belovictor/Tripod/stl/Middle-bracket.stl

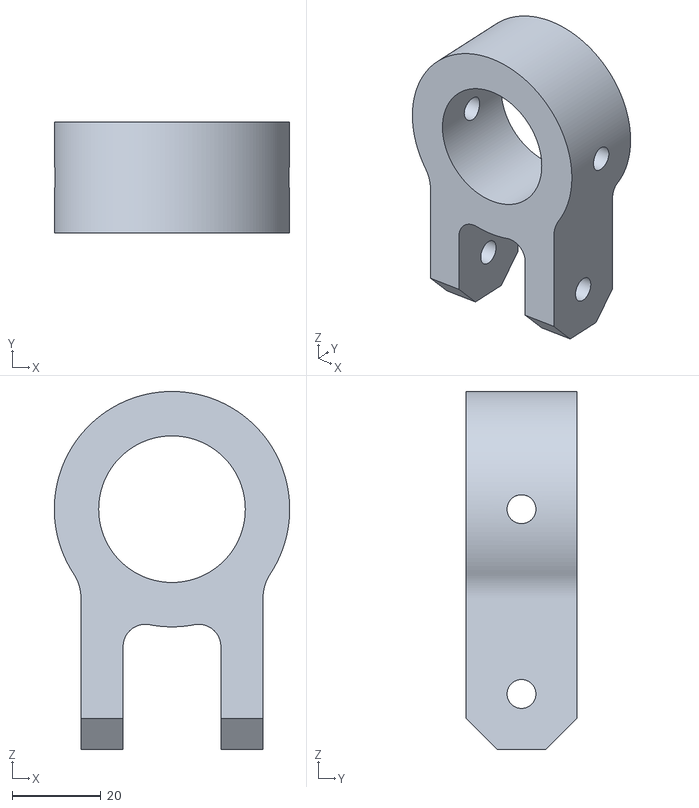
[picture p4: CAD file, 2023-02-11]
stl/Middle-bracket.stl
53.0 x 25.0 x 80.6
