belovictor/Tripod/stl/Foot.stl

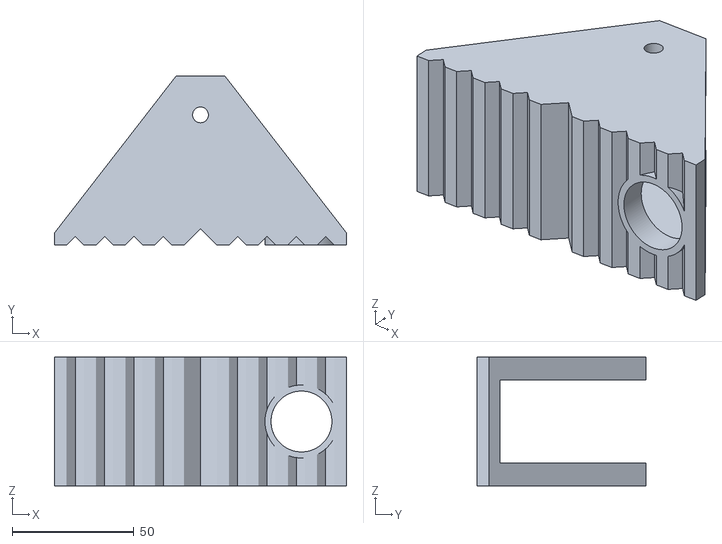
[picture p5: CAD file, 2023-02-11]
stl/Foot.stl
120.0 x 69.5 x 53.0
