belovictor/Tripod/stl/Bottom-cross.stl

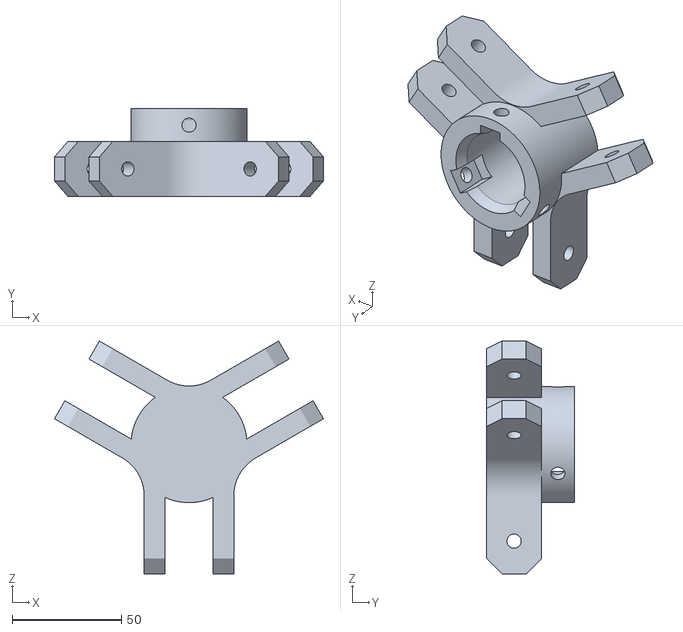
[picture p6: CAD file, 2023-02-11]
stl/Bottom-cross.stl
122.9 x 40.0 x 106.4
