belovictor/Tripod/stl/Top-cross.stl

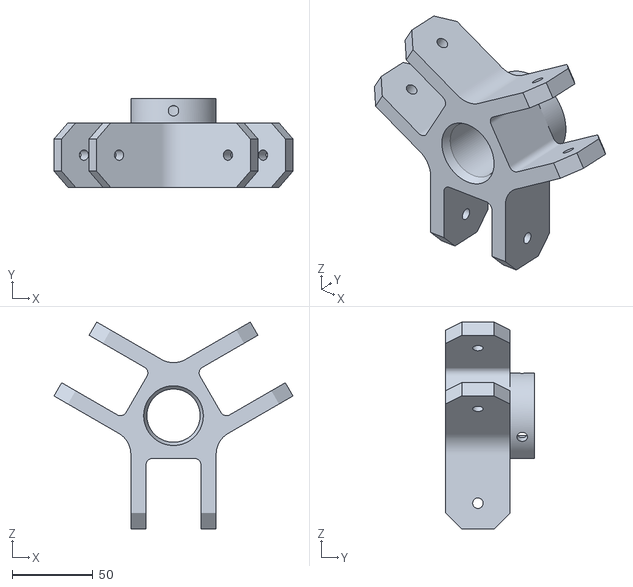
[picture p7: CAD file, 2023-02-11]
stl/Top-cross.stl
148.3 x 55.0 x 128.4
