belovictor/Tripod/pipes/Bottom-tube-20x220mm.pdf

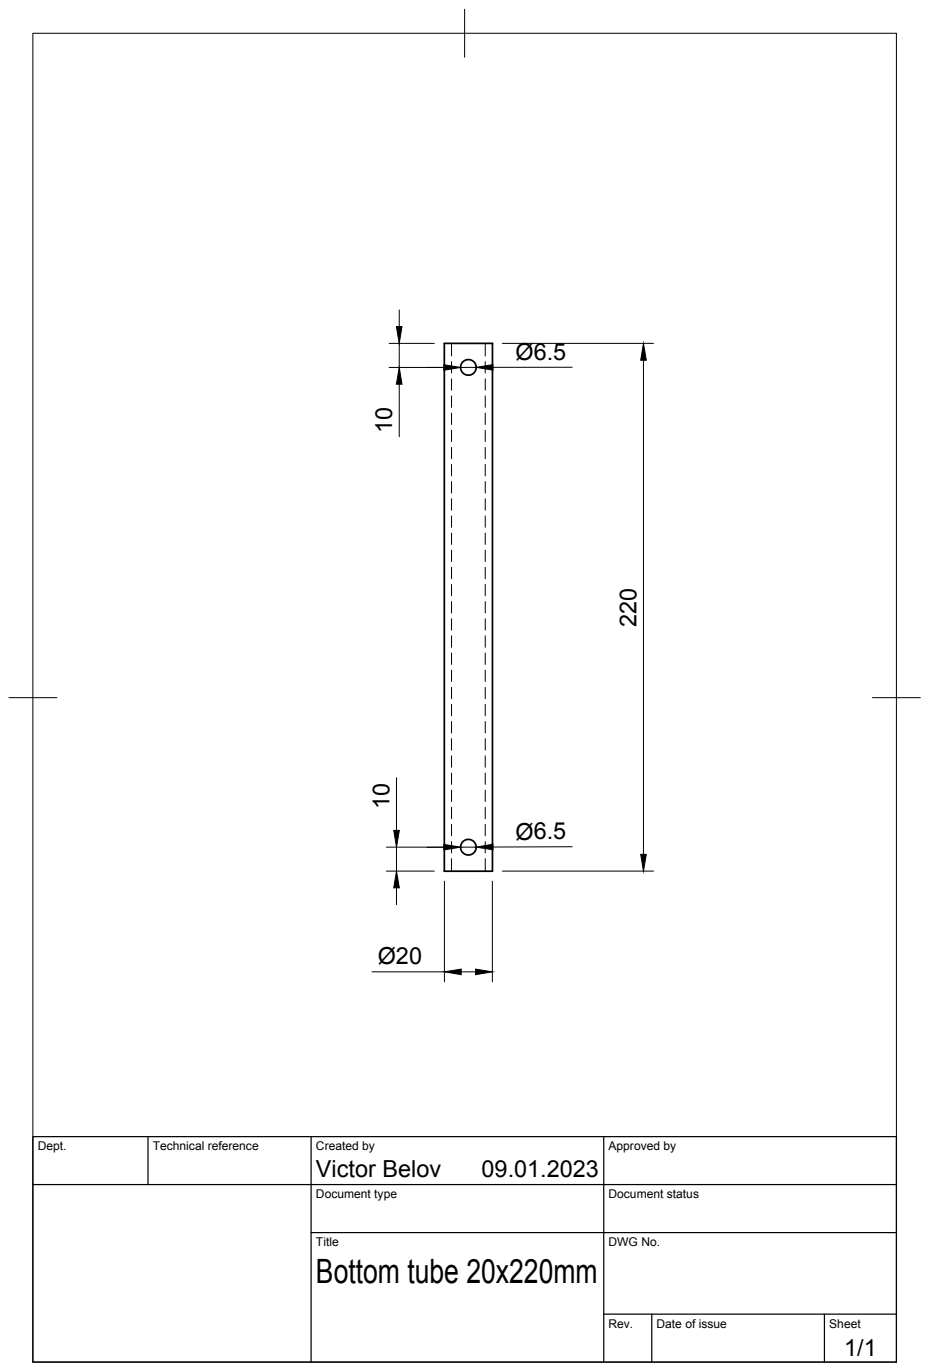
[picture p8: page 1]

Dept. | Technical reference | Created by Victor Belov 09.01.2023 | Approved by

Document type | Document status

Title Bottom tube 20x220mm | DWG No.

Rev. | Date of issue | Sheet 1/1
