belovictor/Tripod/pipes/Foot-tube-32x900mm.pdf

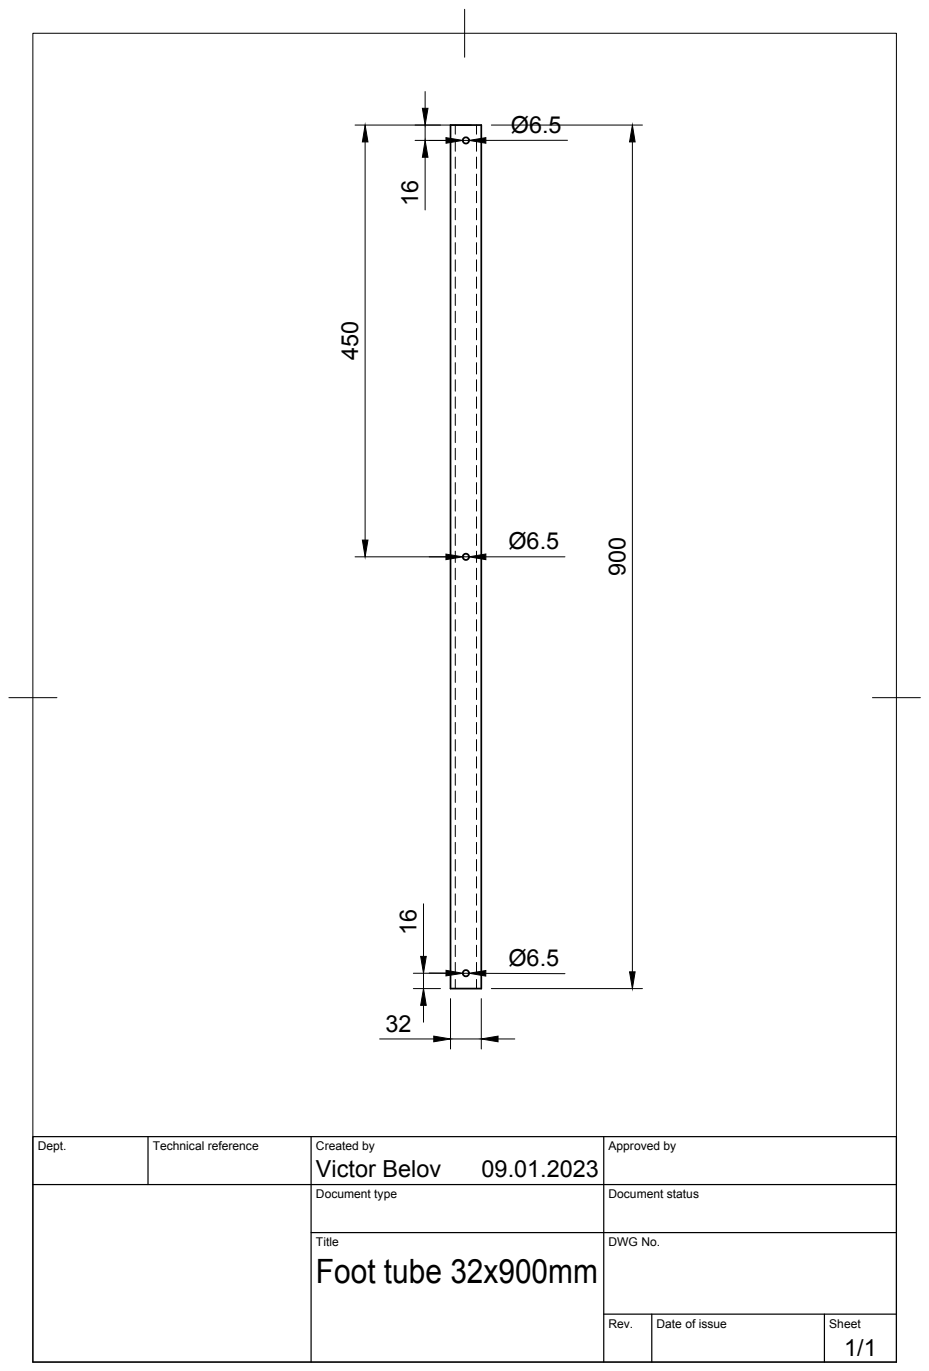
[picture p9: page 1]
Victor Belov

Dept. | Technical reference | Created by 09.01.2023 | Approved by

Document type | Document status

Title Foot tube 32x900mm | DWG No.

Rev. | Date of issue | Sheet 1/1
