belovictor/Tripod/pipes/Vertical-tube-32x1000mm.pdf

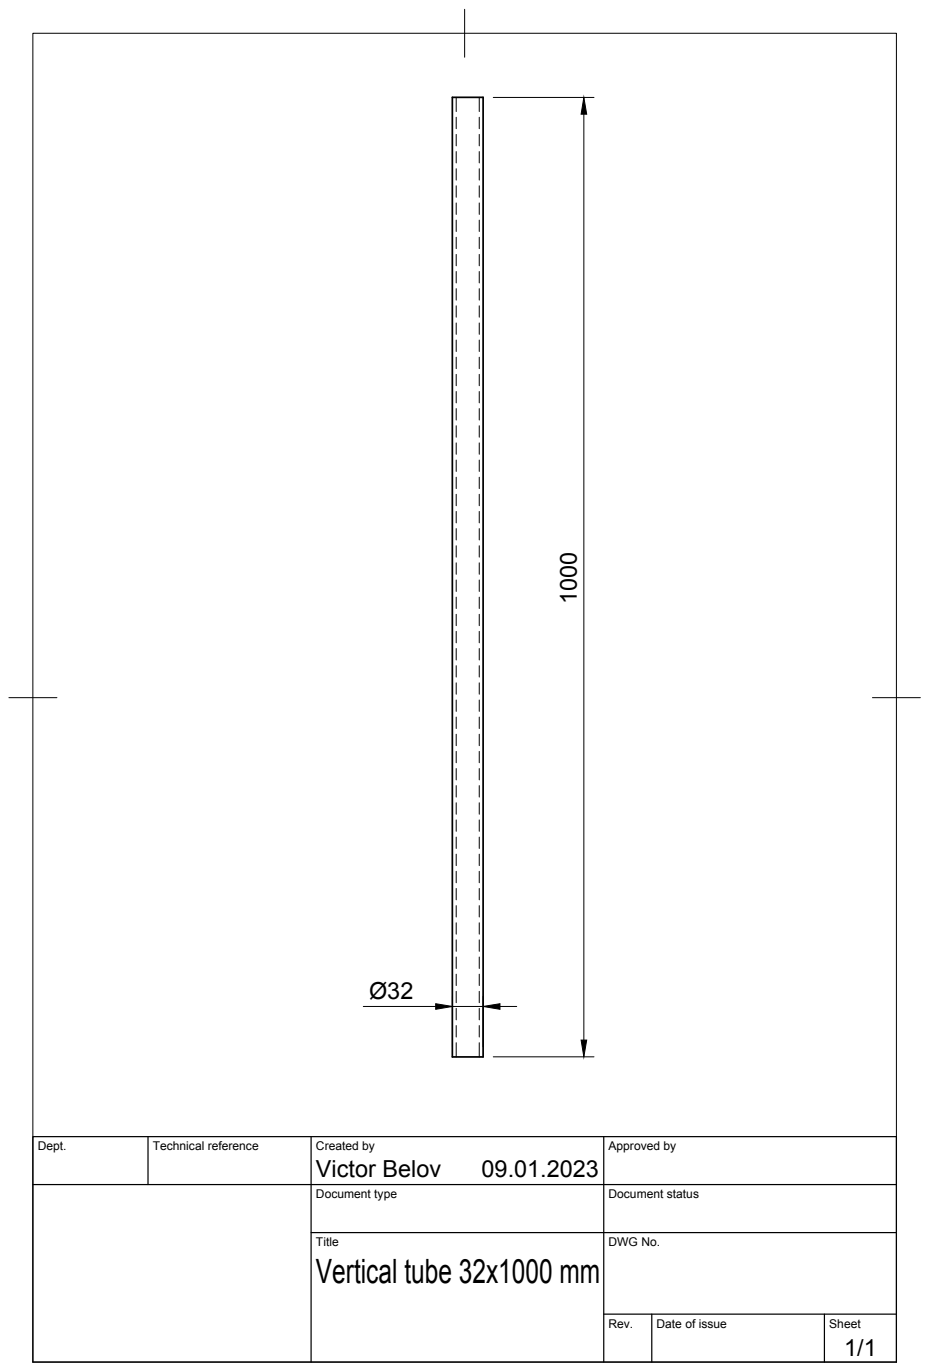
[picture p10: page 1]
Victor Belov

Dept. | Technical reference | Created by 09.01.2023 | Approved by

Document type | Document status

Title Vertical tube 32x1000 mm | DWG No.

Rev. | Date of issue | Sheet 1/1
